BoujeeEnjinia1701/stepclimber/cad/drawings/SCM-DWG-101.pdf

BUILD PLAN SKETCH, PLAN NOT YET BUILT StepClimber · github.com/BoujeeEnjinia1701/stepclimber

FRONT VIEW
Scale 1:2; looking at the front (along +Y)

TOP VIEW
Scale 1:2; looking down (along -Z)

RIGHT VIEW
Scale 1:2; looking at the right side (along -X)

92

4 144

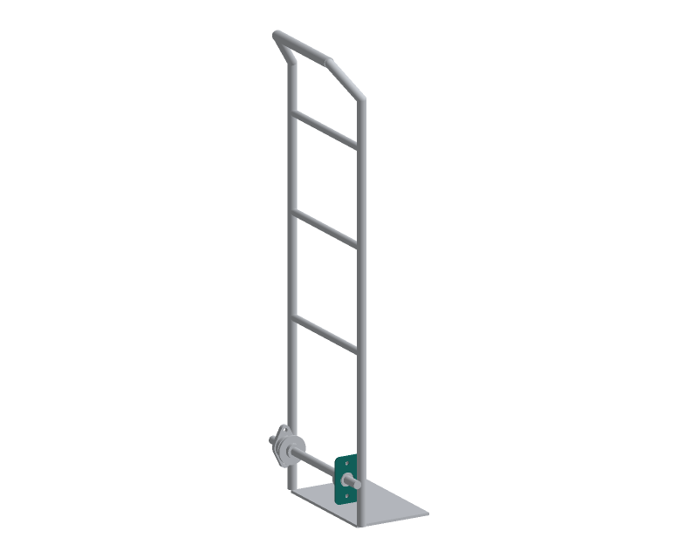
[picture p43: figure]

WHERE IT GOES
This part in colour, its neighbours in grey

HOW TO MAKE IT AND HOW IT FITS
Laser cut 92 x 144 mm, 15 mm corner radius, from 4 mm steel.
Bearing bore 44 mm: 40 mm from the back edge, 72 mm from the bottom. Bearing bolt holes 13 mm, 49.5 mm above and below the bore centre. The back edge faces the stair; the front edge faces the load.
Fit: weld it to the inside face of the left rail, its bore centre
40 mm behind the rail centre line and 142.5 mm above the toe plate. Fillet weld both sides along the rail, 150 mm long.
Weld it with the outer case plate on a straight 25 mm bar through both bores, so the two bores line up.
The 25 mm flange bearing bolts to its inside face with two M12 bolts, nyloc nuts on the outside.
Check: the bar turns freely in both bores after welding.
REV | DESCRIPTION | DATE | BY
P1 | Making sketch for the prototype build plan | 2026-10-01 | AC
STEPCLIMBER | github.com/BoujeeEnjinia1701/stepclimber

## StepClimber axle plate, plain side: making sketch

DRAWING NO.
SCM-DWG-101

REV
P1

SHEET
1 of 1

SIZE

## ANSI B

SCALE
1:2

UNITS
mm
PROJECTION | DATE
2026-10-01

DRAWN
Amish Chadha

MATERIAL / NOTES
Steel plate 4 mm, S275 or similar
Licensed CERN-OHL-S-2.0 · Design Molecule Lab · designmolecule.com | Generated from cad/src; do not edit by hand
