BoujeeEnjinia1701/stepclimber/cad/drawings/SCM-DWG-102.pdf

BUILD PLAN SKETCH, PLAN NOT YET BUILT StepClimber · github.com/BoujeeEnjinia1701/stepclimber

FRONT VIEW
Scale 1:5; looking at the front (along +Y)

TOP VIEW
Scale 1:5; looking down (along -Z)

RIGHT VIEW
Scale 1:5; looking at the right side (along -X)

133

3 418

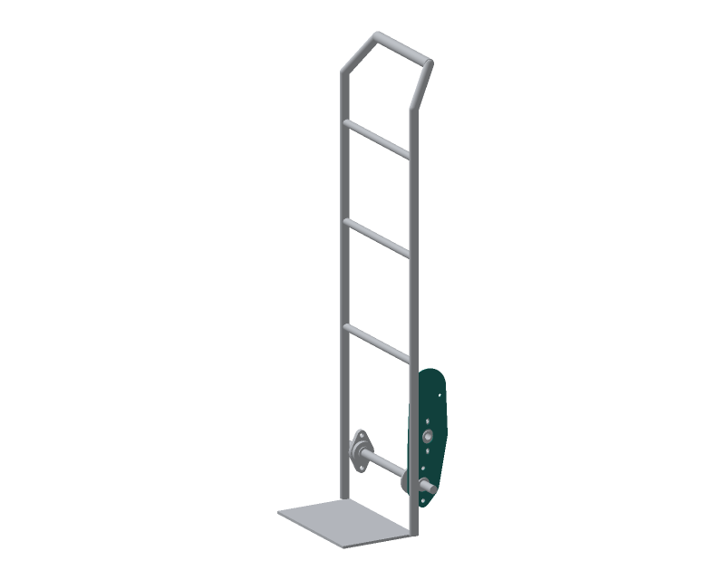
[picture p44: figure]

WHERE IT GOES
This part in colour, its neighbours in grey

HOW TO MAKE IT AND HOW IT FITS
Laser cut to the outline shown, 133 x 418 mm, from 3 mm steel.
All positions from the main bore centre, up the plate and toward
the back (the stair side); the hole layout picture repeats them.
Main bore 44 mm; its bolt holes 13 mm at 49.5 mm above and below. Countershaft bore: a 36 mm slot, 143.9 mm up, 15 mm back,
8 mm long up the plate; bolt slots 11 mm wide, 45 mm above and below it, also 8 mm long. The slots let the chains be tensioned. Spacer holes 9 mm, 262 mm up, 55 mm back and 25 mm forward; countersink them on the outside face.
Fit: weld to the inside face of the right rail like the axle plate, on the same alignment bar; the countersinks face the rail. Check: nothing stands proud of the outside face but the welds.
REV | DESCRIPTION | DATE | BY
P1 | Making sketch for the prototype build plan | 2026-10-01 | AC
STEPCLIMBER | github.com/BoujeeEnjinia1701/stepclimber

## StepClimber chain case outer plate: making sketch

DRAWING NO.
SCM-DWG-102

REV
P1

SHEET
1 of 1

SIZE

## ANSI B

SCALE
1:5

UNITS
mm
PROJECTION | DATE
2026-10-01

DRAWN
Amish Chadha

MATERIAL / NOTES
Steel plate 3 mm, S275 or similar
Licensed CERN-OHL-S-2.0 · Design Molecule Lab · designmolecule.com | Generated from cad/src; do not edit by hand
