BoujeeEnjinia1701/stepclimber/cad/drawings/SCM-DWG-103.pdf

BUILD PLAN SKETCH, PLAN NOT YET BUILT StepClimber · github.com/BoujeeEnjinia1701/stepclimber

FRONT VIEW
Scale 1:5; looking at the front (along +Y)

TOP VIEW
Scale 1:5; looking down (along -Z)

RIGHT VIEW
Scale 1:5; looking at the right side (along -X)

133

3 418

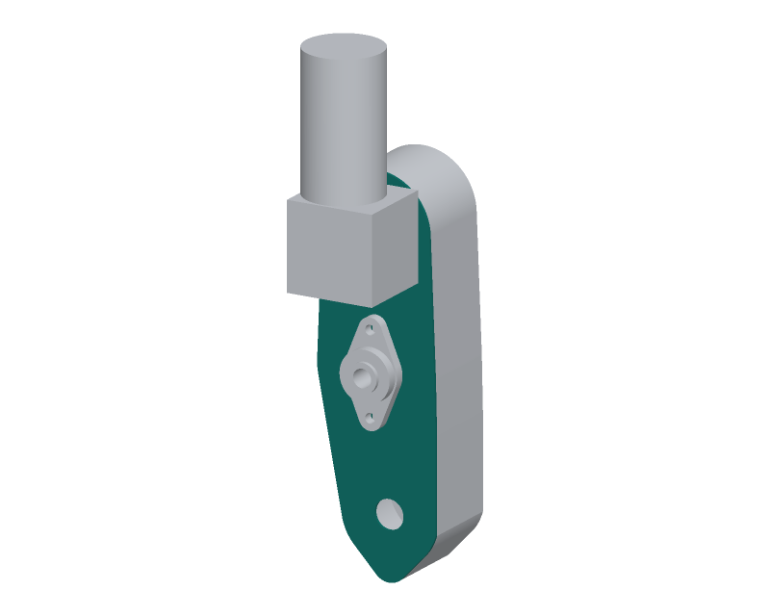
[picture p45: figure]

WHERE IT GOES
This part in colour, its neighbours in grey

HOW TO MAKE IT AND HOW IT FITS
Laser cut to the same outline as the outer plate, from 3 mm aluminium. Holes from the main shaft centre, as on the outer plate, except:
shaft hole 32 mm (clearance, no bearing on this plate);
gearmotor output hole 28 mm, 289 mm up, 15 mm back;
gearmotor screw slots 9 mm wide, 8 mm long up the plate: 40 mm either side of the output hole and 40 mm above it;
countershaft bolt slots countersunk on the case side.
Spacers (make 2): 16 mm bar, 86 mm long, ends square, drilled 6.8 and tapped M8 20 deep at both ends.
Fit: the spacers stand between the plates on M8 screws, countersunk through the outer plate, button heads on this plate's outside.
Check: the plates are parallel, 86 mm apart, at the spacers.
REV | DESCRIPTION | DATE | BY
P1 | Making sketch for the prototype build plan | 2026-10-01 | AC
STEPCLIMBER | github.com/BoujeeEnjinia1701/stepclimber

## StepClimber chain case inner plate and spacers: making sketch

DRAWING NO.
SCM-DWG-103

REV
P1

SHEET
1 of 1

SIZE

## ANSI B

SCALE
1:5

UNITS
mm
PROJECTION | DATE
2026-10-01

DRAWN
Amish Chadha

MATERIAL / NOTES
Aluminium plate 3 mm, 5052 or 5083; spacers 16 mm steel bar
Licensed CERN-OHL-S-2.0 · Design Molecule Lab · designmolecule.com | Generated from cad/src; do not edit by hand
