BoujeeEnjinia1701/stepclimber/cad/drawings/SCM-DWG-104.pdf

BUILD PLAN SKETCH, PLAN NOT YET BUILT StepClimber · github.com/BoujeeEnjinia1701/stepclimber

FRONT VIEW
Scale 1:5; looking at the front (along +Y)

TOP VIEW
Scale 1:5; looking down (along -Z)

RIGHT VIEW
Scale 1:5; looking at the right side (along -X)

133

86 418

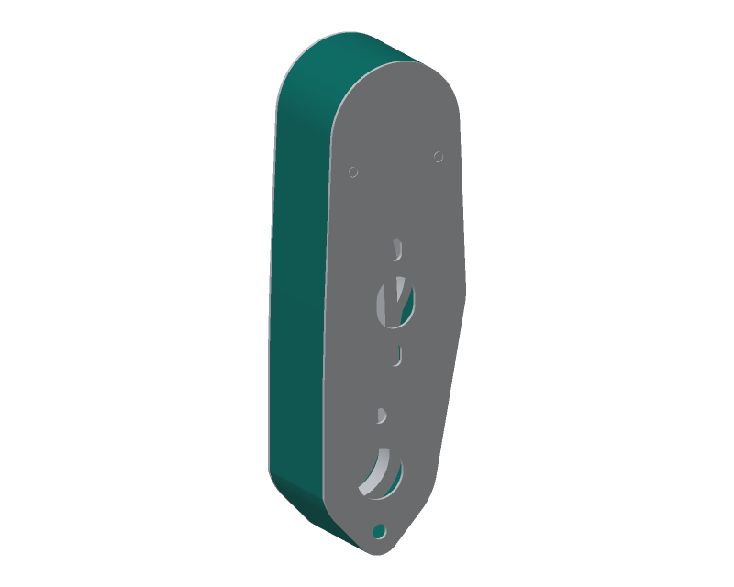
[picture p46: figure]

WHERE IT GOES
This part in colour, its neighbours in grey

HOW TO MAKE IT AND HOW IT FITS
Cut a strip 86 mm wide and 985 mm long from 1.5 mm aluminium. Bend it round the plate outline (front view), starting at the bottom of the load side; the ends overlap 30 mm there.
Bend the tight curves over a 50 mm round bar; ease the long straights by hand. Keep the edges straight and square.
Rivet eight small aluminium angle tabs inside the band, 3 mm in from each edge: four for each plate, spread round the outline. Drill each tab and the plate behind it 4.5 mm for an M4 screw. Fit: the band sits between the plates, flush with their edges.
It goes on last, after the chains are tensioned.
Check: no gap wider than 2 mm between the band and either plate; turn the shafts by hand: nothing rubs the band.
REV | DESCRIPTION | DATE | BY
P1 | Making sketch for the prototype build plan | 2026-10-01 | AC
STEPCLIMBER | github.com/BoujeeEnjinia1701/stepclimber

## StepClimber chain case band: making sketch

DRAWING NO.
SCM-DWG-104

REV
P1

SHEET
1 of 1

SIZE

## ANSI B

SCALE
1:5

UNITS
mm
PROJECTION | DATE
2026-10-01

DRAWN
Amish Chadha

MATERIAL / NOTES
Aluminium sheet 1.5 mm, 5052
Licensed CERN-OHL-S-2.0 · Design Molecule Lab · designmolecule.com | Generated from cad/src; do not edit by hand
