BoujeeEnjinia1701/stepclimber/cad/drawings/SCM-DWG-105.pdf

BUILD PLAN SKETCH, PLAN NOT YET BUILT StepClimber · github.com/BoujeeEnjinia1701/stepclimber

FRONT VIEW
Scale 1:5; looking at the front (along +Y)

TOP VIEW
Scale 1:5; looking down (along -Z)

RIGHT VIEW
Scale 1:5; looking at the right side (along -X)

305

65 270

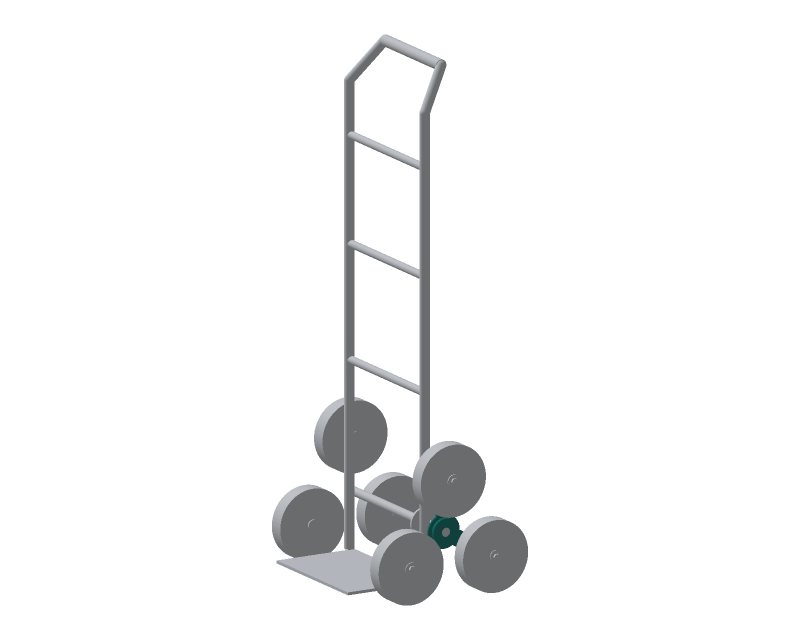
[picture p47: figure]

WHERE IT GOES
This part in colour, its neighbours in grey

HOW TO MAKE IT AND HOW IT FITS
Laser cut two spiders from 6 mm steel: three arms 45 mm wide at 120 degrees, round ends of 22.5 mm radius, a 96 mm centre disc. Holes: 76 mm in the centre for the hub; 20 mm for each stub axle, 150 mm from the centre (260 mm apart, hole to hole).
Hub: a 1610 weld-on taper-lock hub, 76 mm across and 26 mm long, through the centre hole, 10 mm proud each side; weld both sides. Stub axles (make 6): 20 mm bright bar cut to 55 mm; drill 8.5 mm and tap M10 20 deep in one end. Push through each 20 mm hole, plain end flush with the spider's inner face; weld both sides. Make the two spiders as a mirrored pair: stubs on the outer side. Check: the stubs are square to the spider within 0.5 mm over 50 mm, and all three at 150 mm, within 0.5 mm, from the centre.
REV | DESCRIPTION | DATE | BY
P1 | Making sketch for the prototype build plan | 2026-10-01 | AC
STEPCLIMBER | github.com/BoujeeEnjinia1701/stepclimber

## StepClimber spider with hub and stub axles (make 2): making sketch

DRAWING NO.
SCM-DWG-105

REV
P1

SHEET
1 of 1

SIZE

## ANSI B

SCALE
1:5

UNITS
mm
PROJECTION | DATE
2026-10-01

DRAWN
Amish Chadha

MATERIAL / NOTES
Steel plate 6 mm S275; 1610 weld-on hub; 20 mm bright bar
Licensed CERN-OHL-S-2.0 · Design Molecule Lab · designmolecule.com | Generated from cad/src; do not edit by hand
