BoujeeEnjinia1701/stepclimber/cad/drawings/SCM-DWG-107.pdf

BUILD PLAN SKETCH, PLAN NOT YET BUILT StepClimber · github.com/BoujeeEnjinia1701/stepclimber

FRONT VIEW
Scale 1:10; looking at the front (along +Y)

TOP VIEW
Scale 1:10; looking down (along -Z)

RIGHT VIEW
Scale 1:10; looking at the right side (along -X)

6

30 642

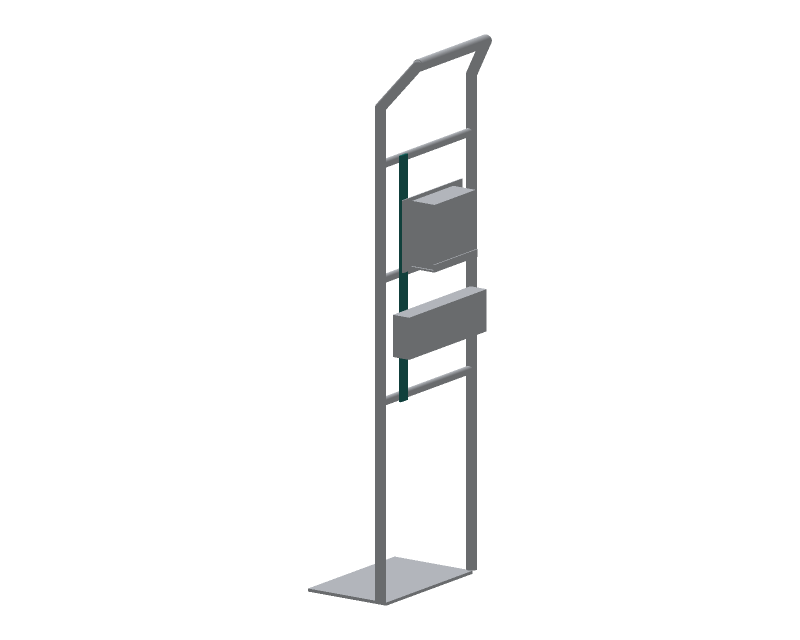
[picture p48: figure]

WHERE IT GOES
This part in colour, its neighbours in grey

HOW TO MAKE IT AND HOW IT FITS
Cut two 642 mm lengths of 30 x 6 mm aluminium flat bar. Holes 6.5 mm on the centre line, 11, 331 and 631 mm from the bottom: these bolt through the three upper cross bars.
Mark the cross bars through the uprights and drill them 6.5 mm, front to back. M6 x 70 bolts, nyloc nuts on the load side.
The uprights stand 120 mm either side of the centre line on the back of the cross bars, bottom 11 mm below the lower bar. Drill for the parts they carry, from the bottom of the upright: electronics box 126 to 236 mm; fuse box 271 to 311 mm;
pack cradle 336 to 526 mm. Use each part's own mounting holes. Deburr all holes. Do not weld aluminium to the steel frame. Check: both uprights sit flat on all three bars.
REV | DESCRIPTION | DATE | BY
P1 | Making sketch for the prototype build plan | 2026-10-01 | AC
STEPCLIMBER | github.com/BoujeeEnjinia1701/stepclimber

## StepClimber component upright (make 2): making sketch

DRAWING NO.
SCM-DWG-107

REV
P1

SHEET
1 of 1

SIZE

## ANSI B

SCALE
1:10

UNITS
mm
PROJECTION | DATE
2026-10-01

DRAWN
Amish Chadha

MATERIAL / NOTES
Aluminium flat bar 30 x 6 mm, 6082 or 6063
Licensed CERN-OHL-S-2.0 · Design Molecule Lab · designmolecule.com | Generated from cad/src; do not edit by hand
