BoujeeEnjinia1701/stepclimber/cad/drawings/SCM-DWG-108.pdf

BUILD PLAN SKETCH, PLAN NOT YET BUILT StepClimber · github.com/BoujeeEnjinia1701/stepclimber

FRONT VIEW
Scale 1:5; looking at the front (along +Y)

TOP VIEW
Scale 1:5; looking down (along -Z)

RIGHT VIEW
Scale 1:5; looking at the right side (along -X)

130

25 500

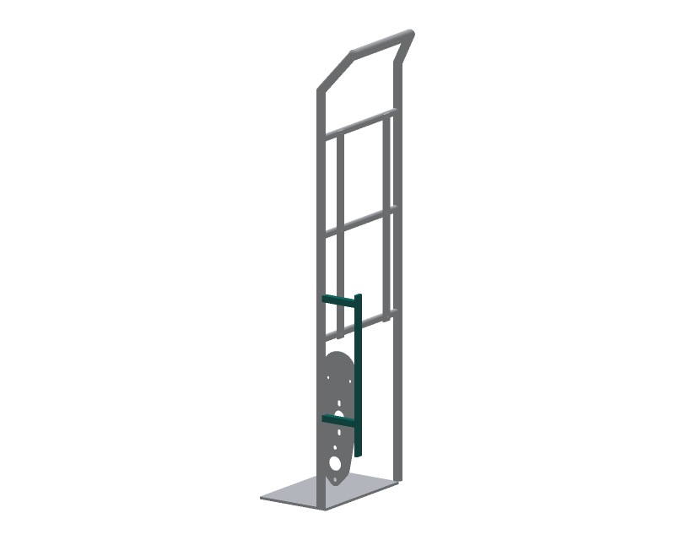
[picture p49: figure]

WHERE IT GOES
This part in colour, its neighbours in grey

HOW TO MAKE IT AND HOW IT FITS
Standoffs (make 4): cut 20 x 20 x 1.5 mm tube to 130 mm. Cope one end to fit the 28 mm rail (file to a 14 mm radius saddle).
Weld a 3 mm cap on the other end; drill 4.2 and tap it M5.
Weld each standoff square to the back of a rail, 140 and 510 mm above the shaft line, so the capped ends stand 100 mm behind the shaft line (90 mm to the cap face).
Skids (2): UHMW strip 25 x 10 mm cut to 500 mm. Countersink two holes 100 and 470 mm from the lower end; screw to the caps with M5 countersunk screws, heads below the skid face.
The skid runs from 40 to 540 mm above the shaft line.
Check: both skid faces in one plane, within 1 mm; the cluster turns past them with 15 mm or more to spare.
REV | DESCRIPTION | DATE | BY
P1 | Making sketch for the prototype build plan | 2026-10-01 | AC
STEPCLIMBER | github.com/BoujeeEnjinia1701/stepclimber

## StepClimber skid standoffs (make 4) and skids (2): making sketch

DRAWING NO.
SCM-DWG-108

REV
P1

SHEET
1 of 1

SIZE

## ANSI B

SCALE
1:5

UNITS
mm
PROJECTION | DATE
2026-10-01

DRAWN
Amish Chadha

MATERIAL / NOTES
Steel square tube 20 x 20 x 1.5 mm; UHMW strip 25 x 10 mm
Licensed CERN-OHL-S-2.0 · Design Molecule Lab · designmolecule.com | Generated from cad/src; do not edit by hand
