BoujeeEnjinia1701/stepclimber/cad/drawings/SCM-DWG-109.pdf

BUILD PLAN SKETCH, PLAN NOT YET BUILT StepClimber · github.com/BoujeeEnjinia1701/stepclimber

FRONT VIEW
Scale 1:5; looking at the front (along +Y)

TOP VIEW
Scale 1:5; looking down (along -Z)

RIGHT VIEW
Scale 1:5; looking at the right side (along -X)

22

383 22

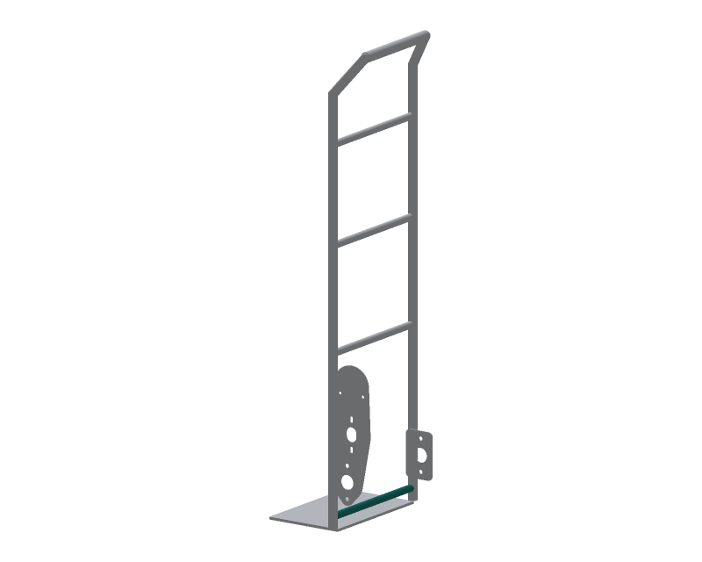
[picture p50: figure]

WHERE IT GOES
This part in colour, its neighbours in grey

HOW TO MAKE IT AND HOW IT FITS
Strip the bought frame: wheels, axle and axle brackets off.
Mark the shaft line on both rails, 142.5 mm above the toe plate. Cut off any cross bar between 80 mm below and 360 mm above the shaft line (on the model frame, the bar 60 mm above it); grind
the rails smooth and paint the bare steel.
Cut 22 mm tube to fit between the rails (372 mm inside); cope both ends to the 28 mm rails.
Weld it between the rails 105 mm below the shaft line, on the rail centre line, square to both rails.
The axle plates and skid standoffs then weld to the rails
(sheets 101, 102 and 108).
Check: rails still 400 mm apart, within 1 mm, at the new bar.
REV | DESCRIPTION | DATE | BY
P1 | Making sketch for the prototype build plan | 2026-10-01 | AC
STEPCLIMBER | github.com/BoujeeEnjinia1701/stepclimber

## StepClimber frame changes and replacement lowest cross bar: making sketch

DRAWING NO.
SCM-DWG-109

REV
P1

SHEET
1 of 1

SIZE

## ANSI B

SCALE
1:5

UNITS
mm
PROJECTION | DATE
2026-10-01

DRAWN
Amish Chadha

MATERIAL / NOTES
Steel tube 22 x 1.5 mm
Licensed CERN-OHL-S-2.0 · Design Molecule Lab · designmolecule.com | Generated from cad/src; do not edit by hand
