BoujeeEnjinia1701/stepclimber/cad/drawings/SCM-DWG-001.png

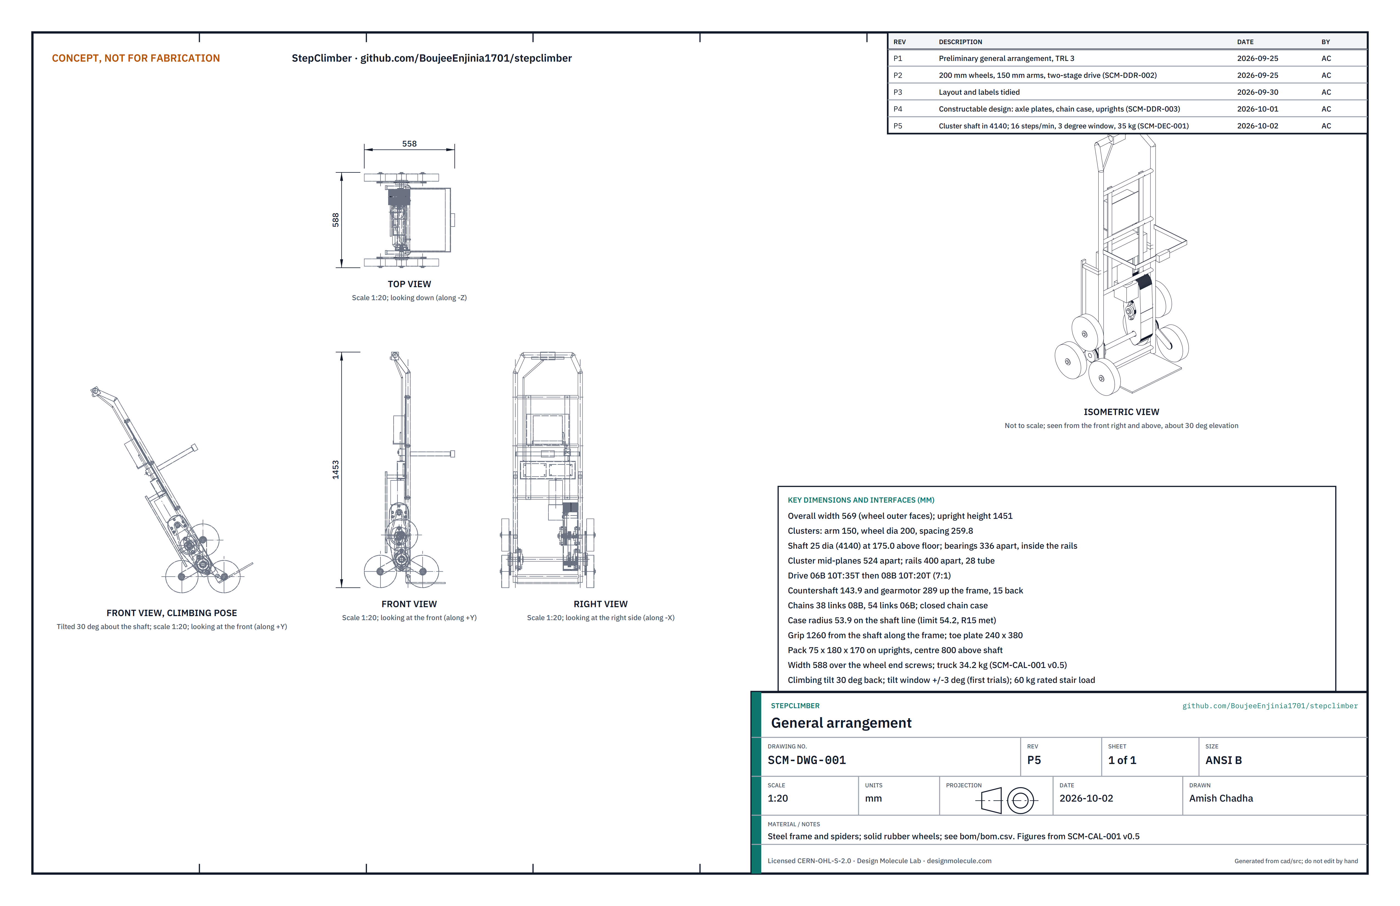
cad/drawings/SCM-DWG-001.png
