BoujeeEnjinia1701/stepclimber/media/card.png

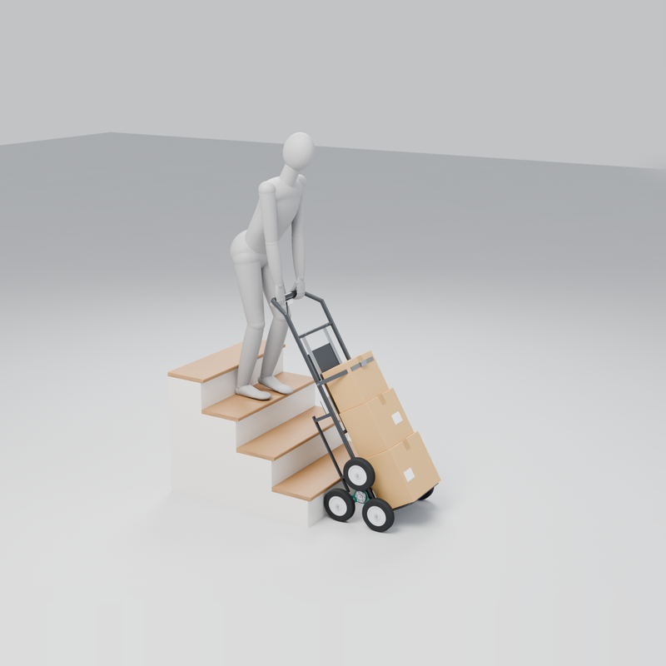
media/card.png
