BoujeeEnjinia1701/stepclimber/media/concept-blueprint.png

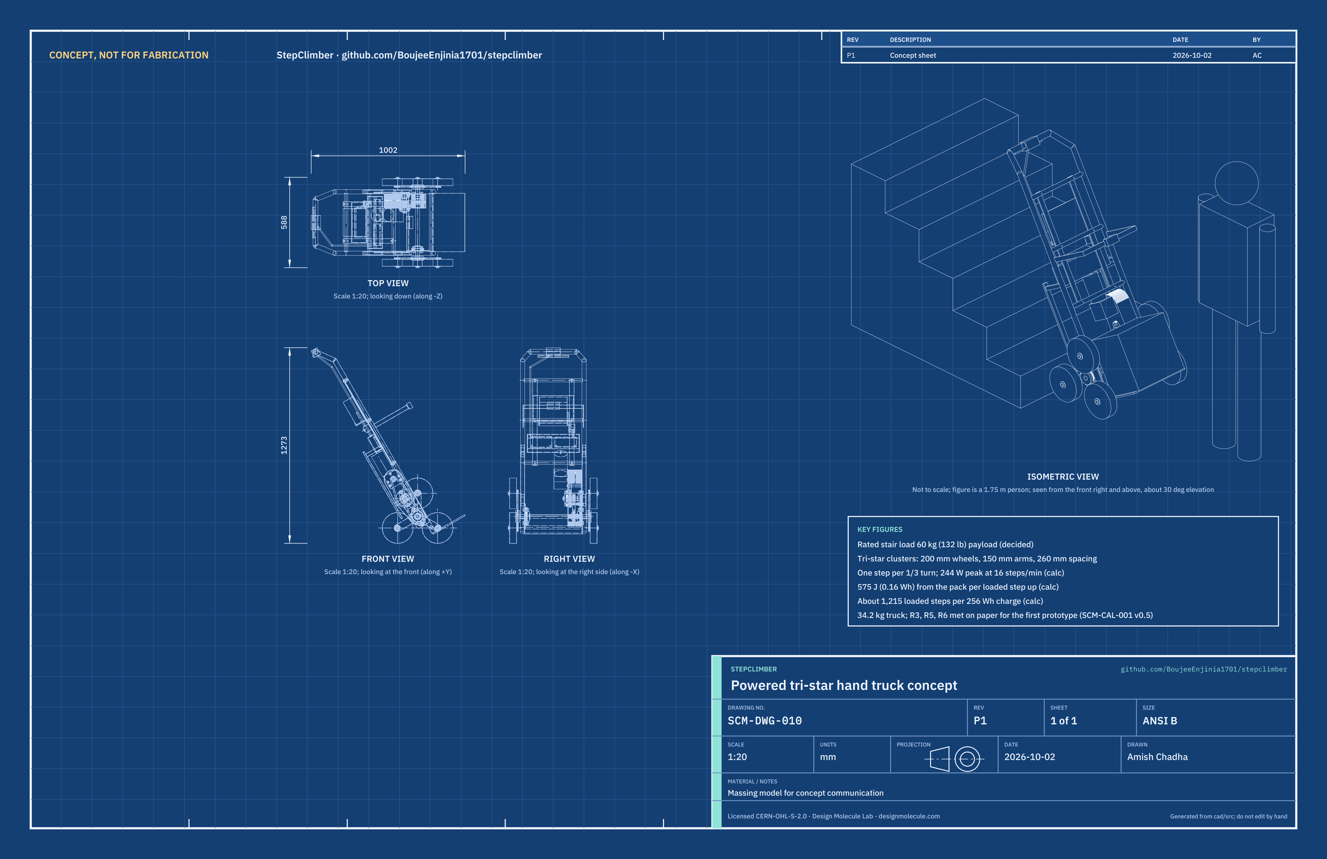
media/concept-blueprint.png
