BoujeeEnjinia1701/stepclimber/media/render-detail.png

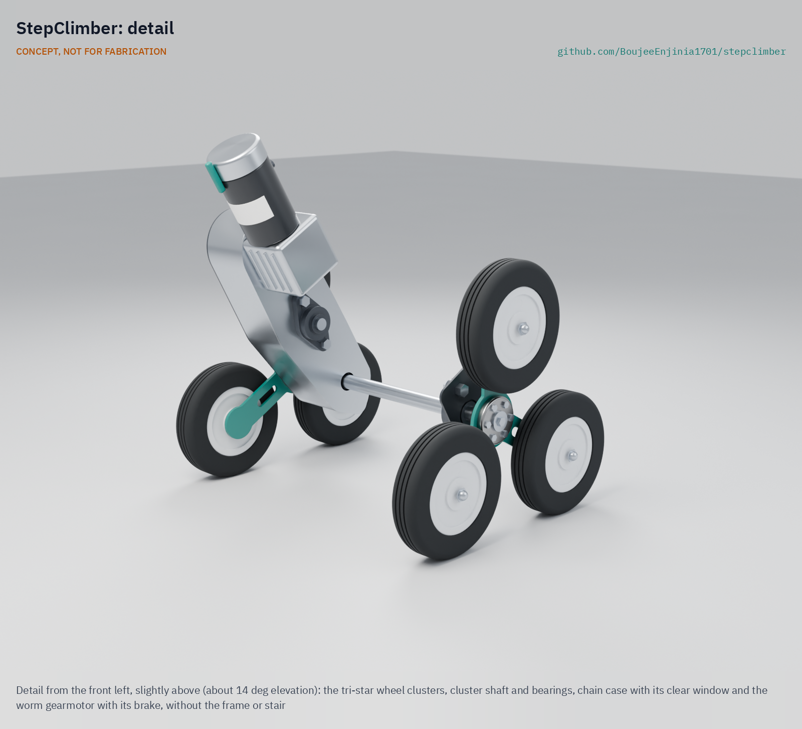
media/render-detail.png
