BoujeeEnjinia1701/stepclimber/media/render-exploded.png

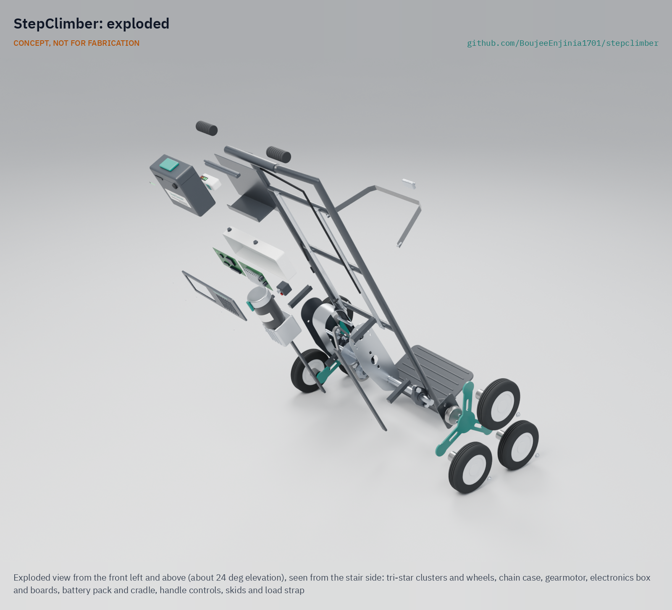
media/render-exploded.png
