BoujeeEnjinia1701/stepclimber/media/social-preview.png

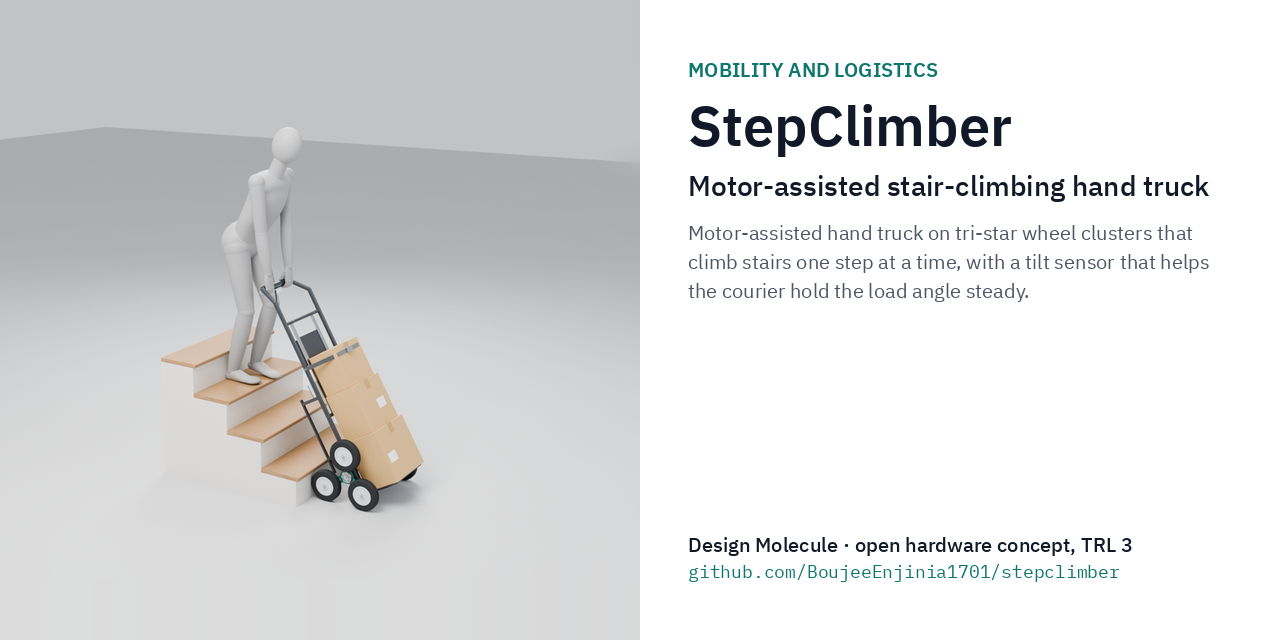
media/social-preview.png
