BoujeeEnjinia1701/stepclimber/bom/bom.csv

item | qty | spec | supplier | unit_cost_usd | make_buy | notes
1 Hand truck frame and toe plate | 1 | Steel loop-handle hand truck, about 1,260 mm rails at 400 mm centers, 380 x 240 mm toe plate; stock wheels and axle removed; lowest cross bar cut off and replaced lower (line 16) | Hardware or industrial supply store | 70.00 | buy | Indicative price for a commercial frame; about 8 kg. Modifications in SCM-BLD-001 and SCM-DWG-101
2 Tri-star wheel clusters (pair) | 1 | Two laser-cut 6 mm steel spiders with 150 mm arms and a 96 mm centre disc; two 1610 weld-on taper-lock hubs with 25 mm keyed bushes; six 20 mm stub axles from bright bar; six 200 x 45 mm solid rubber non-marking wheels on 20 mm sealed bearings | Online laser-cut service (for example SendCutSend) plus caster wheel supplier | 116.00 | make | Indicative price (wheels about $9 each; spiders about $34; weld-on hubs and bushes about $28); arms clear 32 mm nosing overhangs; about 5.5 kg plus 0.8 kg of stub axles (SCM-CAL-001 v0.3)
3 Cluster shaft and two-stage chain drive | 1 | 25 mm keyed shaft 490 mm in 4140 quenched and tempered alloy steel (mill certificate), in two 25 mm two-bolt flange bearings; 20 mm keyed countershaft 124 mm in two 20 mm two-bolt flange bearings; first stage 06B 10T to 35T, 54 links; final stage 08B 10T to 20T, 38 links (7:1 overall); connecting links | Power transmission supplier (for example McMaster-Carr) | 108.00 | buy | Indicative price: 96.00 for the drive with a 1018 shaft plus about 12.00 for 4140 quenched and tempered bar (about 22 per metre at 25 mm, 0.5 m needed, with keyway milled and mill certificate, over about 8 for bright 1018 bar); the chain case that guards both stages is line 14; 08B chain safety factor 4.0; about 5.5 kg itemised (SCM-CAL-001 v0.4); decided 2026-10-02 (SCM-DEC-001, item 1)
4 Worm gearmotor with brake | 1 | 24 V brushed, about 250 W, worm gearbox about 40 rpm output, 30 N·m rated or more, integral spring-applied electromagnetic brake | Wheelchair or mobility motor supplier | 110.00 | buy | Indicative price; needs 25.8 N·m at 40 rpm and a brake of 0.24 N·m or more (SCM-CAL-001 v0.2); self-locking worm plus brake give two independent holds
5 Motor driver | 1 | 24 V, 30 A continuous brushed H-bridge with current sensing and brake-release output | Electronics distributor | 30.00 | buy | Indicative price
6 Controller with IMU tilt sensor | 1 | Small microcontroller board, 6-axis IMU, LED light bar and buzzer | Electronics distributor | 25.00 | buy | Indicative price; shares a sealed enclosure with item 5
7 Battery pack | 1 | 24 V LiFePO4, 8S 10 Ah (256 Wh), BMS with cell-level protection and low-temperature charge block, quick-release cradle | Battery supplier | 120.00 | buy | Indicative price; about 2.6 kg
8 Main switch fuse and harness | 1 | Key switch, 40 A fuse in sealed holder near the pack, keyed connectors, 2.5 mm2 wiring | Electronics distributor | 20.00 | buy | Indicative price
9 Handle controls | 1 | Dead-man grip lever switch, up and down thumb switch, status light bar mount | Electronics or mobility parts supplier | 20.00 | buy | Indicative price
10 Load strap | 1 | 25 mm ratchet strap, fixed to the frame | Hardware store | 10.00 | buy | Indicative price
11 Nosing guard skids | 2 | UHMW polyethylene strip, 500 x 25 x 10 mm | Plastics supplier (for example McMaster-Carr) | 5.00 | buy | Indicative price
12 Charger | 1 | 29.2 V, 3 A LiFePO4 charger | Battery supplier | 25.00 | buy | Indicative price; no exploded-view callout
13 Enclosure and hardware | 1 | IP54 enclosure for items 5 and 6 with standoffs and cable glands, cable ties, thread locker | Hardware store | 25.00 | buy | Indicative price; no exploded-view callout
14 Axle plates and chain case | 1 | Laser-cut: plain-side axle plate 4 mm steel; case outer plate 3 mm steel (drive-side axle plate); case inner plate 3 mm aluminium; case band 1.5 mm aluminium, bent; two 16 mm round spacers 83 mm, tapped M8 | Online laser-cut and bending service plus metal stockist | 55.0 | make | Indicative price; added to make the design buildable (SCM-DDR-003); about 2.5 kg
15 Component uprights | 2 | Aluminium flat bar 30 x 6 mm, 642 mm long, drilled | Metal stockist | 6.0 | make | Indicative price; carry the electronics box, pack cradle and fuse box (SCM-DDR-003)
16 Frame modification steel | 1 | 22 mm x 1.5 mm steel tube 400 mm (replacement lowest cross bar); 20 x 20 x 1.5 mm square tube 520 mm and 3 mm plate offcuts (four skid standoffs with end caps) | Metal stockist | 10.0 | make | Indicative price (SCM-DDR-003)
17 Fixings added for construction | 1 | Bearing bolts 4 x M12 x 40 and 4 x M10 x 35 with nyloc nuts, 2 x M10 countersunk; 6 x M10 x 20 wheel end screws with 36 mm washers and 6 x 4.5 mm wheel spacers; 3 x M8 gearmotor screws; 4 x M8 spacer screws; 6 x M6 x 70 upright bolts; 4 x M5 countersunk skid screws; band screws | Fastener supplier | 22.0 | buy | Indicative price (SCM-DDR-003)
