BoujeeEnjinia1701/stepclimber/cad/step/stepclimber-assembly.step

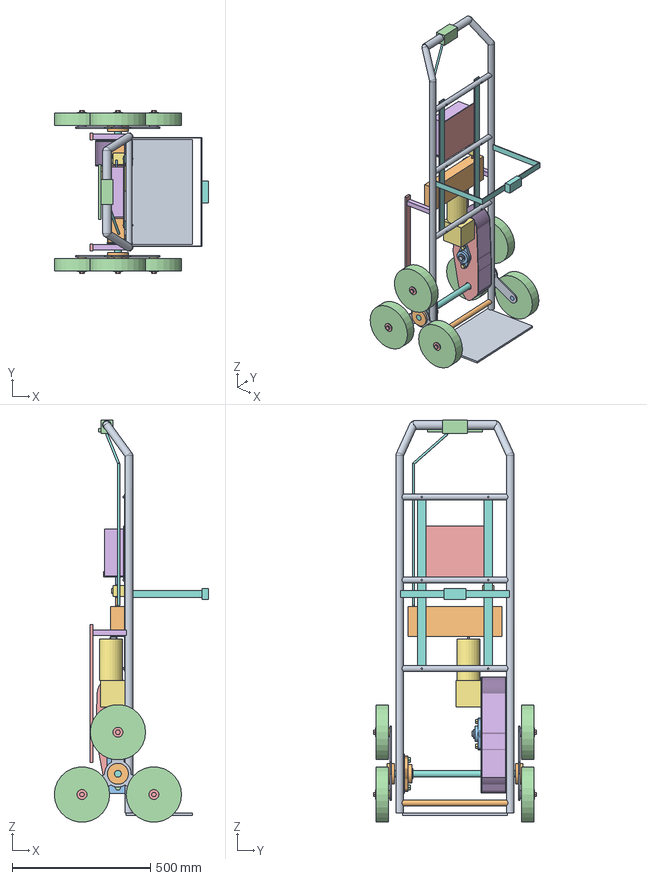
[picture p60: CAD file, 2026-10-03]
cad/step/stepclimber-assembly.step
557.9 x 587.8 x 1452.3 mm
