BoujeeEnjinia1701/stepclimber/cad/step/stepclimber-frame.step

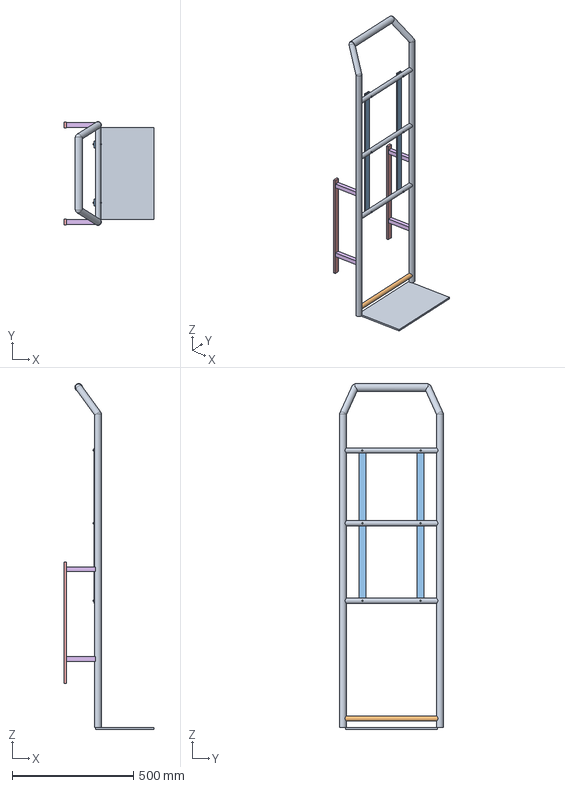
[picture p61: CAD file, 2026-10-03]
cad/step/stepclimber-frame.step
370.0 x 428.0 x 1426.5 mm
