BoujeeEnjinia1701/stepclimber/cad/step/stepclimber-drive.step

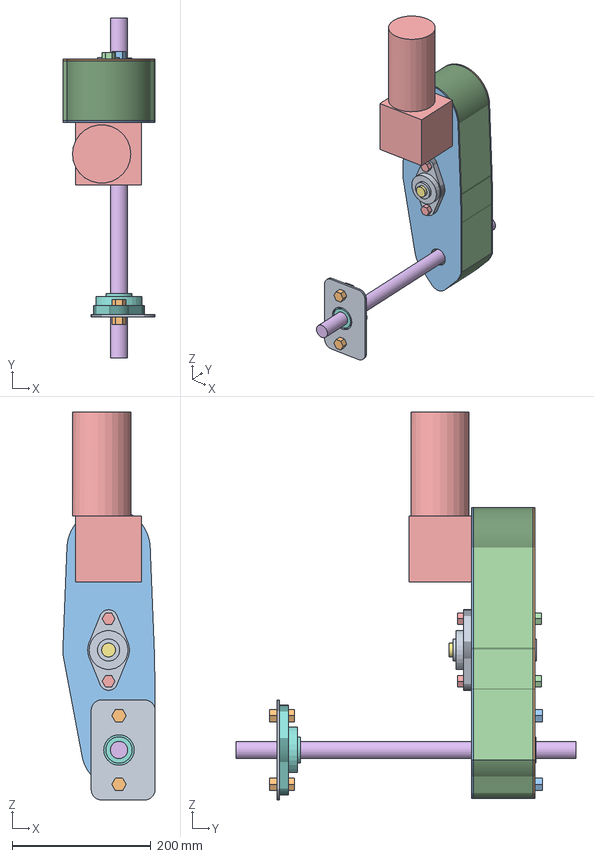
[picture p62: CAD file, 2026-10-03]
cad/step/stepclimber-drive.step
132.8 x 490.0 x 558.5 mm
