BoujeeEnjinia1701/stepclimber/cad/step/stepclimber-cluster-pair.step

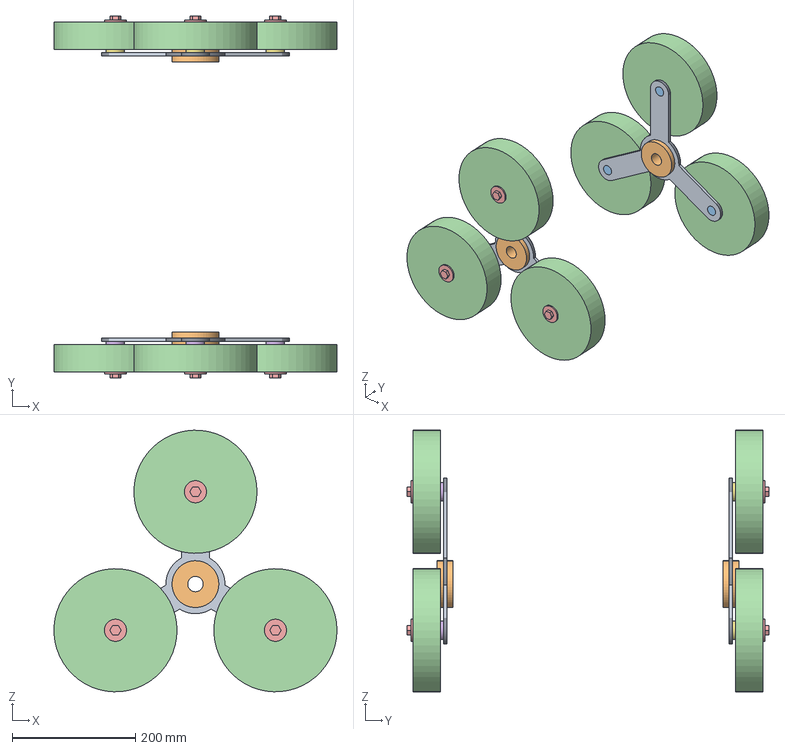
[picture p63: CAD file, 2026-10-03]
cad/step/stepclimber-cluster-pair.step
459.6 x 587.8 x 424.9 mm
