BoujeeEnjinia1701/stepclimber/(list of files, cad)

Other CAD files:
cad/stl/stepclimber-assembly.stl
cad/stl/stepclimber-cluster-pair.stl
cad/stl/stepclimber-drive.stl
cad/stl/stepclimber-frame.stl
