BoujeeEnjinia1701/stepclimber/.kit/templates/build-plan.md

---
doc_id: PRJ-BLD-001
title: Project prototype build plan
project: Project name
doc_type: Build plan
version: "0.1"
status: Draft
date: YYYY-MM-DD
author: Amish Chadha
license: CERN-OHL-S-2.0
revisions:
  - version: "0.1"
    date: YYYY-MM-DD
    author: Amish Chadha
    change: First build plan; design made constructable
---

# Project prototype build plan

**Plan, not yet built.** How to build the first proof-of-concept prototype, component by component. Building and testing to it is TRL 4 work. Decisions still to be made are kept in the design decisions register (`docs/06-design-decisions.md`), not here.

## 1. What you are building

Every component, pulled apart and numbered in build order

One short paragraph: what the prototype is, how many components, which are made and which are bought, and the main ways they are made.

## 2. What changed to make it buildable

| Component | The concept had | The buildable design has | Why |
| --- | --- | --- | --- |

## 3. Making the components

### 3.1 Component name

Making sketch

**What it is and what it is made from.**

**How to make it.**

1. Mark out ...
2. Cut ...

**How it fits the parts next to it.**

Close-up of the joint

**Check before moving on.**

## 4. Putting it together

### Step 1: ...

Step 1

## 5. First checks

| Check | Requirement | How | Pass when |
| --- | --- | --- | --- |

## 6. Safety stops

## 7. Tools, skills and workspace

## 8. Where the numbers come from
