BoujeeEnjinia1701/stepclimber/docs/05-build-plan/joint-08.png

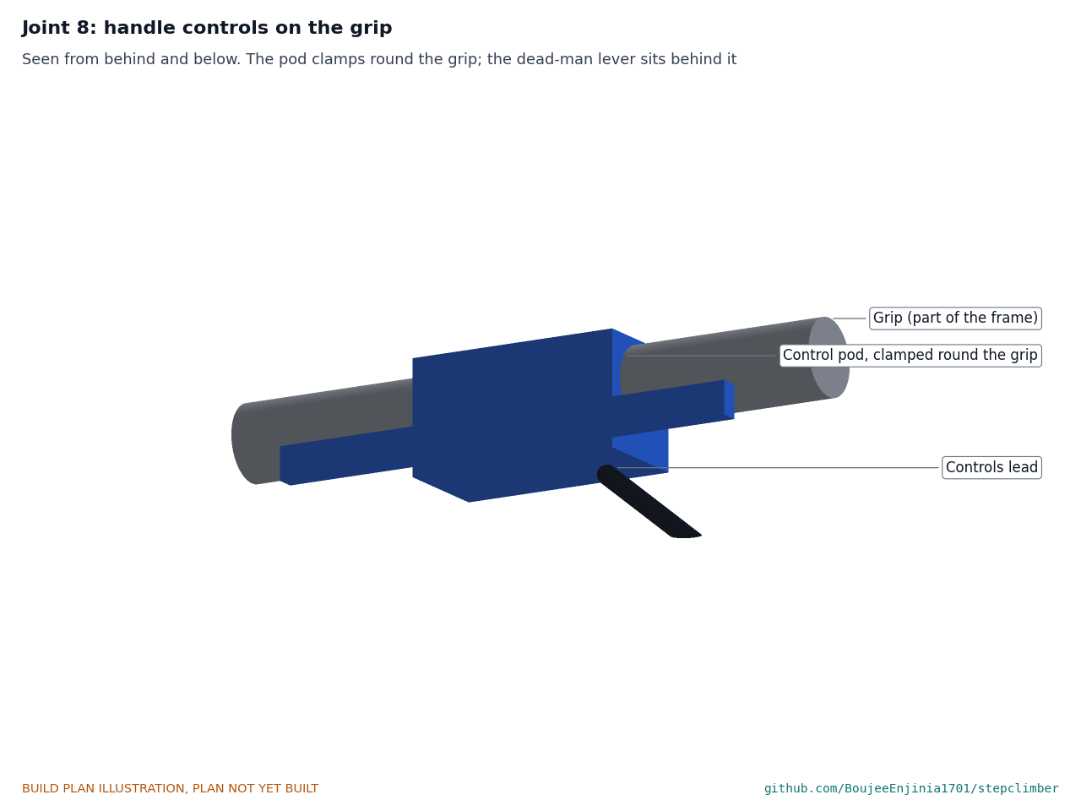
docs/05-build-plan/joint-08.png
