BoujeeEnjinia1701/stepclimber/media/concept-blueprint.pdf

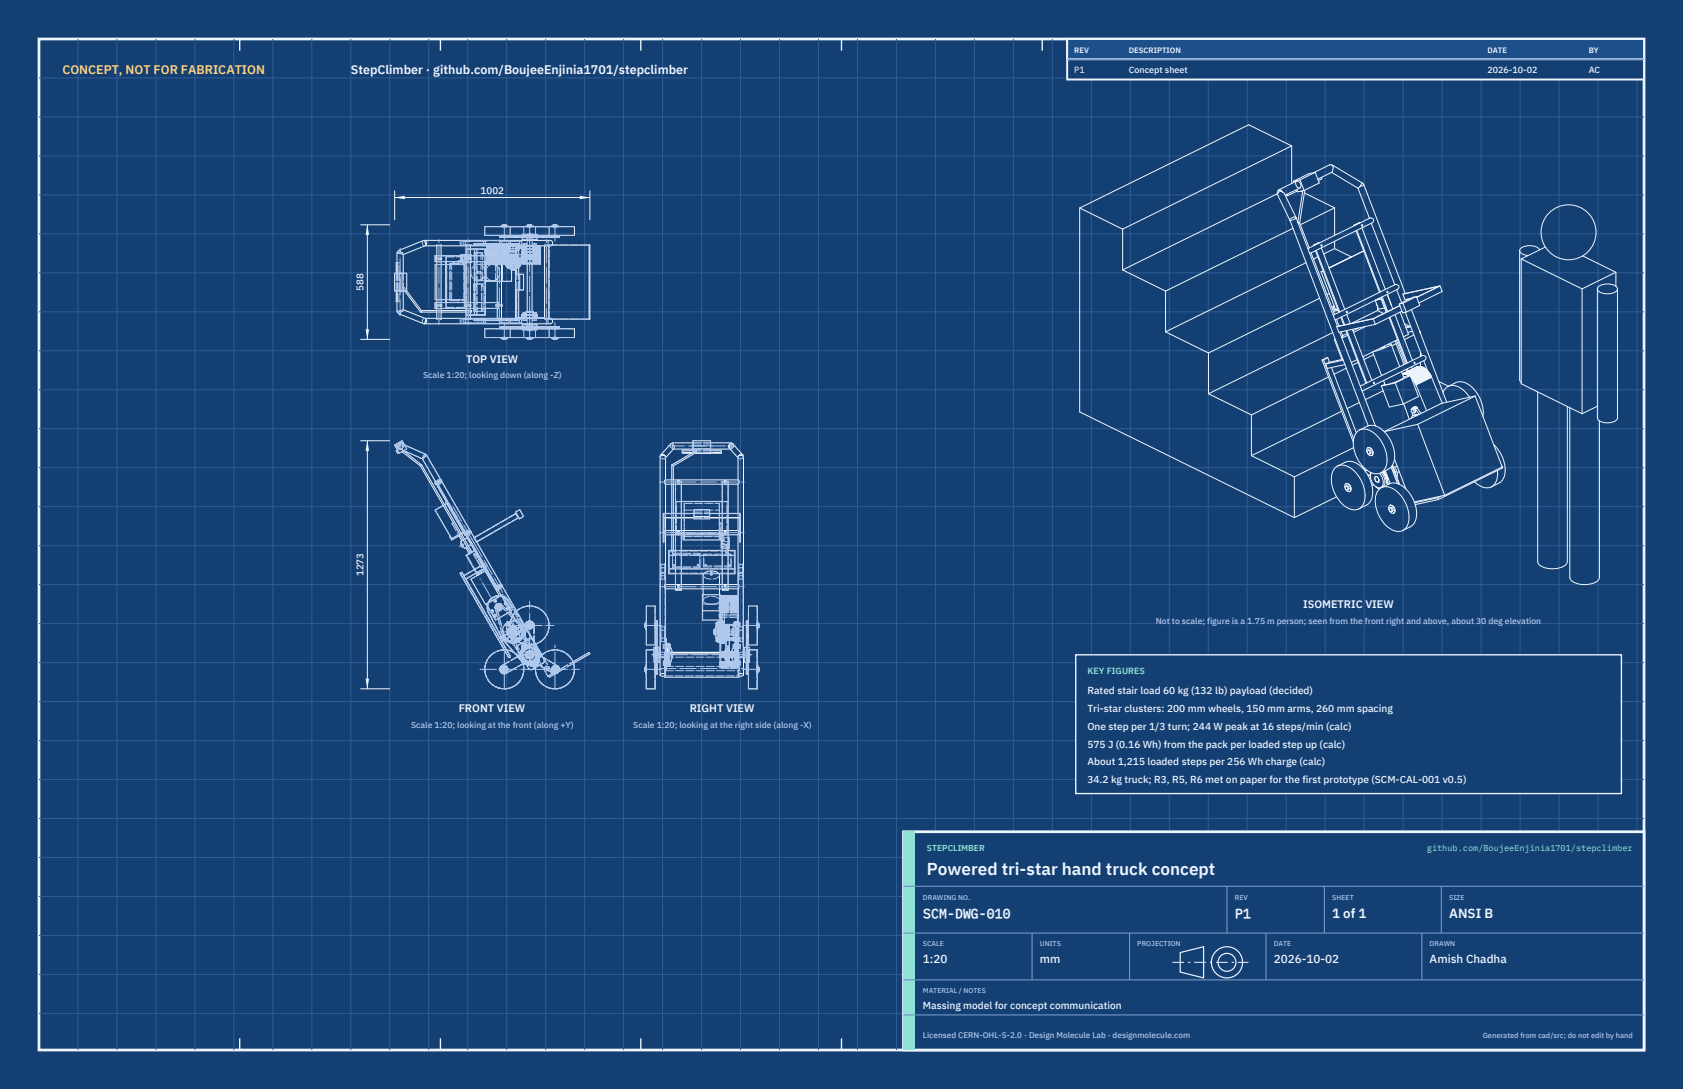
[picture p66: page 1]
CONCEPT, NOT FOR FABRICATION; StepClimber · github.com/BoujeeEnjinia1701/stepclimber; FRONT VIEW; TOP VIEW; RIGHT VIEW; ISOMETRIC VIEW; REV; DESCRIPTION; DATE; Concept sheet; STEPCLIMBER; github.com/BoujeeEnjinia1701/stepclimber; DRAWING NO. SCM-DWG-010; REV P1; SHEET 1 of 1; SIZE ANSI B; SCALE 1:20; UNITS mm; PROJECTION; DRAWN Amish Chadha; Licensed CERN-OHL-S-2.0 · Design Molecule Lab · designmolecule.com; Generated from cad/src; do not edit by hand

Scale 1:20; looking down (along -Z)

Not to scale; figure is a 1.75 m person; seen from the front right and above, about 30 deg elevation

KEY FIGURES
Rated stair load 60 kg (132 lb) payload (decided)
Tri-star clusters: 200 mm wheels, 150 mm arms, 260 mm spacing
One step per 1/3 turn; 244 W peak at 16 steps/min (calc)
575 J (0.16 Wh) from the pack per loaded step up (calc)
About 1,215 loaded steps per 256 Wh charge (calc)
34.2 kg truck; R3, R5, R6 met on paper for the first prototype (SCM-CAL-001 v0.5)

Scale 1:20; looking at the front (along +Y)

Scale 1:20; looking at the right side (along -X)

Powered tri-star hand truck concept

MATERIAL / NOTES
Massing model for concept communication
