BoujeeEnjinia1701/stepclimber/(commit log)

2026-09-24 Initial scaffold: standard open hardware layout, CERN-OHL-S v2 + MIT licenses
    Claude-Session: https://claude.ai/code/session_01XuhhSU4W6fYhgCfURbrkut
    [bom.csv]
2026-09-25 Adopt portfolio kit v1.3.0: session commands, scale figure, 3D viewer, flow diagrams
    Adds .claude/commands (/populate, /advance-trl3, /rein-in, /refresh-media)
    so every Claude Code session starts from the standard prompts, and extends
    concept media with a 1.75 m scale figure, an interactive glTF viewer and
    system or energy flow diagrams. TRL cap 3 unchanged.
    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
2026-09-25 Kit v1.3.1: renderer fixes from the TremorTrace pilot
    Context scale parts for small objects, cutaway exclusions, and text
    labels in flow diagrams.
    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
2026-09-25 Populate stepclimber to a strong TRL 2 with concept media (batch 3)
    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
    [bom.csv]
2026-09-25 Advance stepclimber to TRL 3 (batch 3)
    Decisions approved by Amish 2026-09-25 recorded in DDR-001. TRL 4 is on hold.
    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
    [bom.csv, results.csv, stepclimber-assembly.step, stepclimber-assembly.stl, stepclimber-cluster-pair.step, stepclimber-cluster-pair.stl, stepclimber-drive.step, stepclimber-drive.stl]
2026-09-26 Accept all recommendations (DDR-002), switch footer to designmolecule.com, add README write-up with new inspiration point
    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
    [bom.csv, results.csv, stepclimber-assembly.step, stepclimber-assembly.stl, stepclimber-cluster-pair.step, stepclimber-cluster-pair.stl, stepclimber-drive.step, stepclimber-drive.stl]
2026-09-27 Product appearance model and photoreal renders
    Adds cad/src/product_model.py (appearance model for renders only, all main
    dimensions from model.py) and Blender renders in media/render-*.png,
    captioned with the project, repository and viewing direction. README leads
    with the product render; trl stays 3.
    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
2026-10-01 Image quality pass: legible exploded views, flow diagrams and drawing sheets
    Kit 1.6.1 image layout: the parts list sits in its own column, number bubbles sit on visible parts and never overlap, small parts get a leader, pictures are cropped to the subject, flow labels keep numbers with their units, and sheet captions and the revision table no longer overprint. Concept images, blueprint and general arrangement sheet regenerated; repo-specific labels moved clear of other text and lines.
2026-10-02 Kit 1.7.0: constructable design, illustrated build plan and design decisions register
    The design is now constructable: every part can be made and fits its neighbours, with each change recorded in a Design for construction decision record (made under Amish's 2026-09-30 instruction; open for his review). docs/05-build-plan.md shows how to make and fit every component, with making sketches, joint close-ups and a picture for every assembly step. Open decisions live in docs/06-design-decisions.md. Model, calculations, drawings, concept media and PDFs regenerated. Cost is stated against the value-engineering target (budget_usd), not as a limit.
    FlexHand also credits Dr. Geeti Chadha as a contribut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
    [bom.csv, results.csv, stepclimber-assembly.step, stepclimber-assembly.stl, stepclimber-cluster-pair.step, stepclimber-cluster-pair.stl, stepclimber-drive.step, stepclimber-drive.stl]
2026-10-02 Record Amish's approval of the open-decision recommendations
    Amish approved the recommendation on every open decision in the design decisions register ("i approve your recommendations for all 555 open decisions.", 2026-10-02). Each decision is moved to Decisions made with the approved choice; design-for-construction records and earlier proposed items are marked accepted where the approval covers them; requirements, pitch wording, safety rules and first partner candidates are carried into the documents. Changes that need CAD, drawings, pictures, BOM or calculation reruns are listed as follow-up actions in docs/REVIEW.md, with the review flags. PDFs regenerated.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
2026-10-03 Carry approved follow-ups into the design and redo photoreal renders
    Amish approved the follow-up actions from the open-decision sign-off ("APPROVED CHANGES, COMPLETE THESE", 2026-10-02), the design-for-construction change tables in ten repos, the last wave's open decisions, and the photoreal re-render ("COMPLETE THESE"). Model, BOM, calculations, drawings and build plan pictures updated to the approved decisions; items that are outreach, TRL 4 or another repo's work are recorded as not done in docs/REVIEW.md. Appearance model rebuilt on the constructable design; photoreal renders redone in Blender Cycles, captioned, and card and social preview regenerated. PDFs regenerated.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
    [bom.csv, results.csv, stepclimber-assembly.step, stepclimber-cluster-pair.step, stepclimber-drive.step, stepclimber-frame.step]
