BoujeeEnjinia1701/stepclimber/(notices)

Notices in the files:
README.md:
Hardware: CERN-OHL-S-2.0
